MarciV2/StudienArbeit_SchnelleWaage/Bilder/IMG20220623155658.jpg

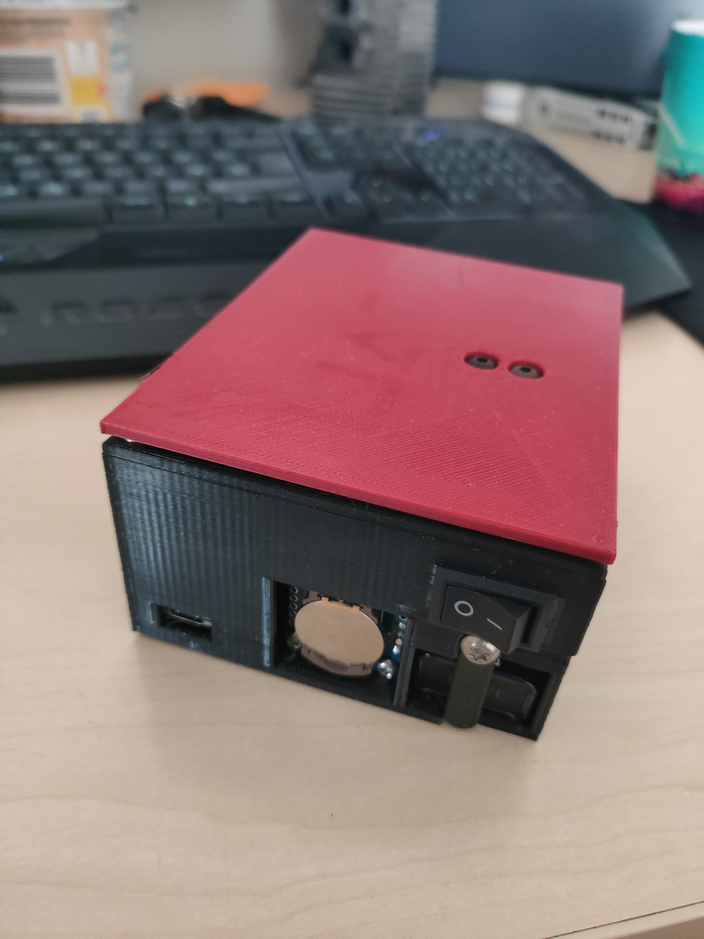
Bilder/IMG20220623155658.jpg
