MarciV2/StudienArbeit_SchnelleWaage/Bilder/IMG20220623155631.jpg

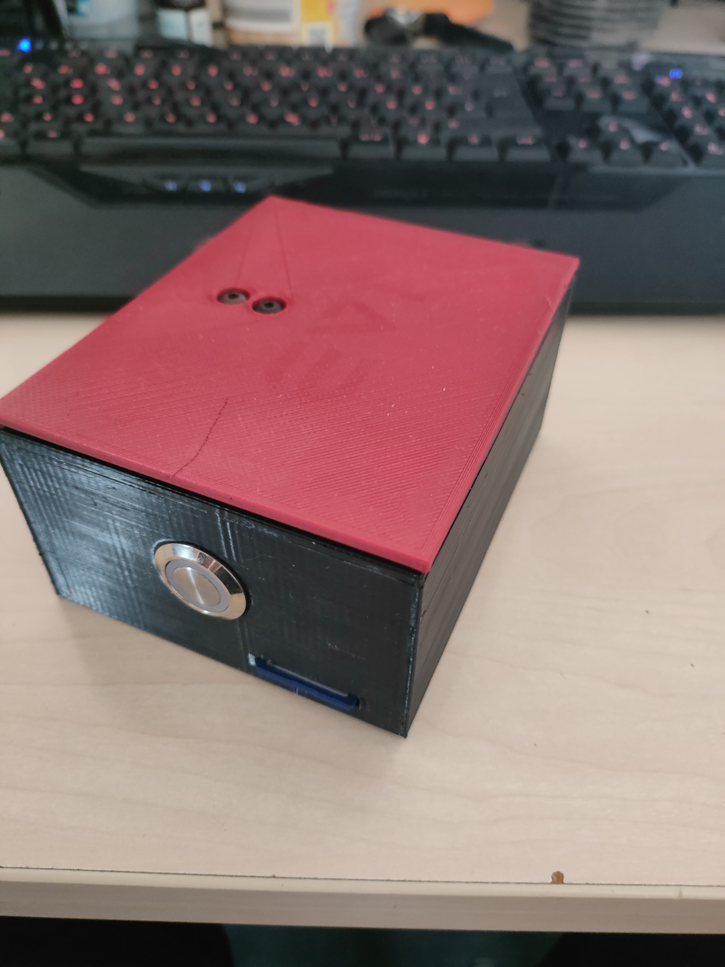
Bilder/IMG20220623155631.jpg
