MarciV2/StudienArbeit_SchnelleWaage/README.md

# StudienArbeit_SchnelleWaage
> **Warning**
 @zukünftiger Marcel: Repo nicht löschen, sodass Zugriff für Neidlinger bestehen bleibt!!!

DOCS: https://docs.google.com/document/d/1Qibr8rgyGZde0_C4LwtIbXJPAC02KLuB511e5A6Qyso/edit#
