MarciV2/StudienArbeit_SchnelleWaage/Verkabelung.xlsx

Von Gerät | Pin | Kabelfarbe | Zu Gerät | Pin
Arduino | D2 | Grau | HX711 | Clk
 | D3 | Weiß |  | Dat
 | D5 | Gelb | Druckschalter
 | D6 | Grün
 | D7 | Blau
 | D8 | Schwarz
 | D10 | Braun | SD-Modul | CS
 | D11 | Rot |  | MOSI
 | D12 | Gelb |  | MISO
 | D12 | Orange |  | SCK
 | A4 | Grau | RTC | SDA
 | A5 | Lila |  | SCL
 | Gnd | Orange | Druckschalter | Gnd
 | Gnd | Schwarz | SD-Modul | Gnd
9V-Batterie | + | Rot | An/Aus-Schalter | Pin1
An/Aus-Schalter | Pin2 | Rot | DC-DC-Wandler | In+
Common-Rail Gnd |  | Schwarz | Druckschalter
 |  | Schwarz | SD-Modul | Gnd
 |  | Schwarz | RTC | Gnd
 |  | Schwarz | DC-DC-Wandler | In-
 |  | Blau |  | Out-
 |  | Schwarz | HX711 | Gnd
 |  | Schwarz | 9V-Batterie | -
Common-Rail 5V |  | Weiß | SD-Modul | 5V
 |  | Weiß | RTC | VCC
 |  | Lila | HX711 | VCC
 |  | Rot | DC-DC-Wandler | Out+
 |  | Rot | Arduino | 5V
