MarciV2/StudienArbeit_SchnelleWaage/(commit log)

2021-10-19 GITIGNORE und GITATTRIBUTES hinzufügen.
2021-10-19 kaufliste angefangen
    [Kaufliste.xlsx]
2022-07-13 Aktuelle Version des Word Files
